bnaditya2007-boop/hasth-vani/images/README.md

# Hasth Vani - images

```
images/
├── diagrams/   PNG renders of the 24 SVGs in hardware/diagrams/
└── design/     Design render of the target two-glove build (not a photo)
```

`design/hasth_vani_design_render.jpg` shows what the finished gloves are
meant to look like. The working prototype is currently on breadboards.
Add real build photos under `photos/` as the hardware comes together.
