bnaditya2007-boop/hasth-vani/images/ChatGPT Image Sep 29, 2026, 01_43_32 PM.png

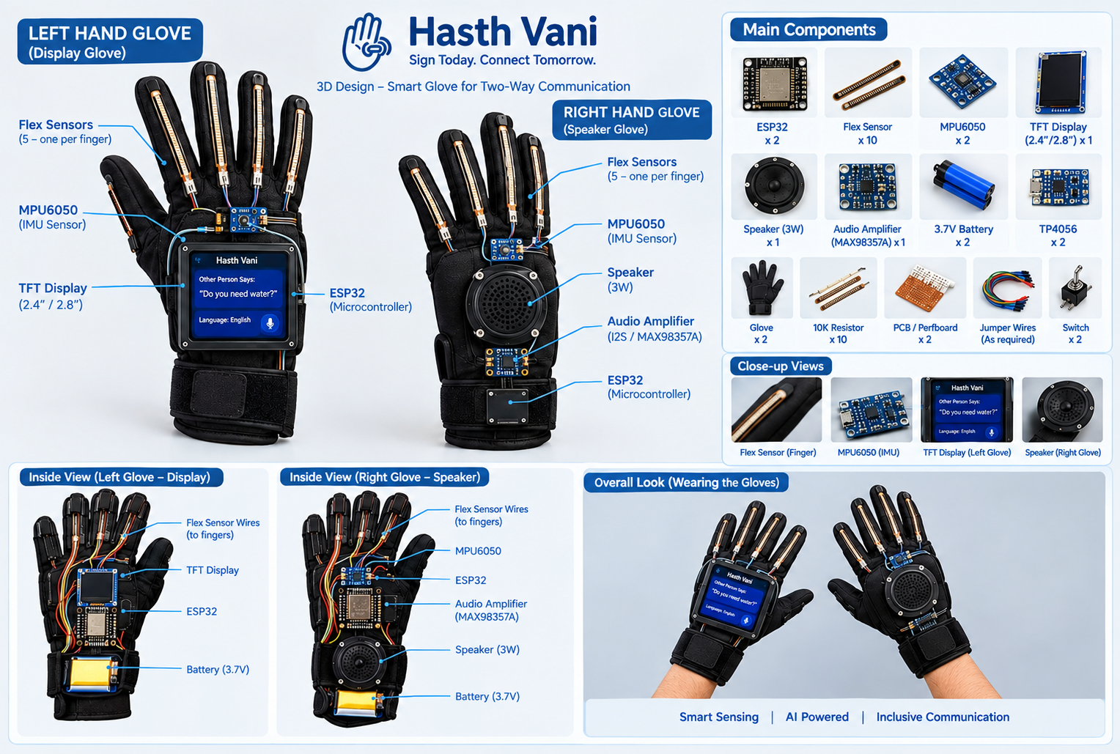
images/ChatGPT Image Sep 29, 2026, 01_43_32 PM.png
