bnaditya2007-boop/hasth-vani/docs/wiring_3d_viewer.html

# Hasth Vani: full LEFT glove circuit, all wires shown (ESP32 + 5 flex sensors + MPU6050 + 2.4 inch TFT shield + battery/USB power)

Everything is wired and visible from the start. Click any wire, sensor, pin label or table row to isolate just that connection — everything else dims. There are two power inputs: USB-C (always on the board) and a battery pack wired to VIN/GND; use one or the other, never both at once. The step list and slider below still exist if you want to replay the build order, but you don't need them to explore the wiring.

◀ BackNext ▶Step 0 of Auto-play auto-zoom

3D view Top view ESP32 pins Sensor / wiring area Labels: on + − Pan: off Reset view Clear highlight

drag = rotate · Shift/right-drag or Pan = move · wheel = zoom · click = highlight

## ALL STEPS click to jump

## What the wire colours mean

- Red = 3.3 V Black = GND
- Blue = I2C (MPU6050 SDA/SCL)
- Yellow = TFT data and control (parallel bus)
- Finger colours = the five ADC signal wires
- Sensor tabs: two DIFFERENT rows

Module pin orders drawn here (MPU6050 and TFT) are the common ones. VERIFY ON ACTUAL MODULE against the silkscreen before you plug in.

## Selected circuit

## ESP32 ADC PIN REFERENCE all five sit on the right pin row (strip 4 side)

- GPIO36 = VP, GPIO39 = VN, GPIO34 = 34, GPIO35 = 35, GPIO32 = 32.
- Your board may print the last three as D34, D35 and D32. It is the same pin.
- GPIO34, 35, 36 and 39 are input-only ADC1 pins, so they are safe to use for reading sensors.
- The five signal wires are never joined. Each one ends in its own breadboard row.

## Breadboard geometry (your six strips)

- Strip 3 = columns f g h i j (left of the ESP32). The ESP32 left pins go into its inner column j; holes f g h i of the same row are free and joined to that pin.
- Strip 4 = columns a b c d e (right of the ESP32). The ESP32 right pins go into its inner column a; holes b c d e are the free ones.
- Strips 2 and 5 are separate strips (not joined to 3 and 4). Strip 5 holds the five sensor circuits; strip 6 is the right power rail (GND inner, 3.3 V outer).
- The 3V3 pin (left row 3) takes a red wire from strip 3 over the top of the ESP32 to the 3.3 V rail. No code trick needed.
- Row numbers: row 3 = the row of the top pin (3V3 on the left, VIN on the right); count downward. Printed numbers on your strips may differ.

## Wiring table every connection, same data as the 3D model (click a row to jump to its step)

Step | Component | From | To | Purpose

## CHECK BEFORE PLUGGING IN USB

## Automatic wiring check (tests the diagram itself)

## Test code for each stage (Arduino IDE, 115200 baud)

Copy code

- Board: ESP32 Dev Module. Open Serial Monitor at 115200.
- Bend one finger sensor and only its own value should change. Values need calibration: with a flat sensor of about 25 kΩ and a 10 kΩ resistor, expect roughly 1000 to 1300 when straight, falling as you bend. The 3190 in the example output is only a format example.
